eplemonsqueezys/Auto-Chicken-Coop/smart_chicken_coop.pptx

Smart Chicken Coop

An Automated Monitoring & Control System

Raspberry Pi 5 · Python · PCA9685 Servo Driver · 7 Automated Systems

## Slide 2

The Story

Why We Built This

We have a chicken coop at home with six hens. Every single day, someone had to walk out and physically check on them.
Was the water topped up? Had the door closed at dusk? Was it getting too hot inside? Had they run out of food?
If we forgot — the chickens could overheat in summer, run out of water, or be left exposed to predators overnight.
We decided to build a system that manages the coop automatically, so we can check on it from our phones instead of going outside every day.

Daily Tasks — Before Automation

Check & refill water drinker

Every morning

Open coop door at sunrise

Every morning

Close coop door at sunset

Every evening

Check temperature in summer

Hot days

Check food hopper level

Every few days

Turn run lights on/off

Daily

## Slide 3

7 Automated Systems

Temperature
Monitor

DHT22 sensor

Vent Sliders

2× MG995 servo

Circulation
Fan

12V PC fan

Water Level
Monitor

Float switches

Automatic
Door

Linear actuator

Automatic
Lights

LED strips

Food Level
Indicator

Lever + pot

## Slide 4

The Hardware

Raspberry Pi 5

Brain of the system

Runs all the Python automation code

64-bit quad-core CPU

Fast enough to handle all sensors at once

WiFi built in

Serves the debug web panel on your network

40-pin GPIO header

Connects to sensors, relays, and motor drivers

I2C + SPI buses

Talks to the PCA9685 and MCP3008 chips

Pi 5 note

Uses the new RP1 GPIO chip — needs lgpio library, not RPi.GPIO

PCA9685 — Servo Driver

Same board used in the workshop dust collection system.
Connects to Pi via I2C (just 4 wires). Controls up to 16 servos from a single board. We use channels 0 and 1 for the two vent sliders.

MCP3008 — Analog Input Chip

The Pi 5 has no analog input pins, so it can't directly read sensors that output a voltage (like the LDR or potentiometer).
The MCP3008 converts analog voltages to digital values over SPI. 8 channels — we use 2: one for the light sensor, one for the food lever.

## Slide 5

Temperature & Ventilation

How It Works

DHT22 reads every 10 sec

Measures temperature and humidity inside the coop

Above 27°C — vents open

Two MG995 servos (via PCA9685) push the vent sliders open

Below 25°C — vents close

2°C gap prevents the servos from constantly toggling

Above 30°C — fan on

12V PC fan switches on via relay to push fresh air through

Below 28°C — fan off

Fan stays off below this to avoid overcooling

Hardware

DHT22 sensor

GPIO4 — single-wire protocol

2× MG995 servo

PCA9685 CH0 + CH1

120mm 12V PC fan

12V rail via relay on GPIO17

1

2

3

if not vents_open and temp >= 27:
set_servo(CH0, SERVOMAX)
set_servo(CH1, SERVOMAX)
vents_open = True
if not fan_on and temp >= 30:
fan.on()
fan_on = True

4

5

## Slide 6

Automatic Chicken Door

How It Works

LDR reads light level

Photoresistor + 10kΩ divider feeds voltage to MCP3008 channel 0

Dawn detection

When light reads above 0.60 (bright) the door should open

Dusk detection

When light reads below 0.30 (dark) AND it's after 8pm

Clock backup

On overcast days the LDR may not trigger — door forces open by 9am

Linear actuator

L298N H-bridge drives actuator forward (open) or backward (close)

Limit switches

Two micro switches stop the motor when the door reaches each end

Hardware

LDR + 10kΩ resistor

Voltage divider → MCP3008 CH0

12V linear actuator

4-6" stroke, 50-100N, self-locking

L298N H-bridge driver

GPIO5 IN1, GPIO6 IN2

2× micro limit switch

GPIO16 (open end), GPIO20 (closed end)

1

2

3

light = ldr.value # 0.0-1.0
is_dawn = (light >= 0.60 or
hour >= 9)
is_dusk = (light <= 0.30 and
hour >= 20)
if is_dawn: open_door()
if is_dusk: close_door()

4

5

6

## Slide 7

Water Level Monitor

How It Works

3 float switches mounted vertically

One at Low, one at Mid, one at Full height inside the water container

Float rises with water level

When water reaches a switch, the float lifts and closes the circuit

Pi reads each switch

The highest active switch determines which LED lights up

Green = Full

All three switches active

Yellow = Mid

Only low and mid switches active

Red = Low / Empty

Only the lowest switch, or none — time to refill

Hardware

3× vertical float switch (NO)

GPIO22 low / GPIO23 mid / GPIO24 high

Red LED

GPIO25 — low/empty

Yellow LED

GPIO27 — mid level

Green LED

GPIO18 — full

1

2

3

if water_high.is_active:
led_green.on() # Full
elif water_mid.is_active:
led_yellow.on() # Mid
elif water_low.is_active:
led_red.on() # Low
else:
led_red.on() # Empty

4

5

6

## Slide 8

Food Level Indicator

How It Works

Lever arm sits in the food hopper

One end of the arm rests on top of the food. As food is eaten, the arm drops

Potentiometer at the pivot point

As the lever rotates, the pot wiper moves — outputting a different voltage

MCP3008 reads the voltage

Converts the analog voltage (0–3.3V) to a digital value (0.0–1.0)

1.0 = full, 0.0 = empty

After fitting the lever, FOOD_LOW_THRESHOLD in config.py is calibrated

Below 25% — red LED on

Exterior panel light turns red, visible from outside the coop

Above 25% — green LED on

Green means the hopper has enough food

Hardware

10kΩ rotary potentiometer

Mounted at lever pivot → MCP3008 CH1

Lever arm

Custom-built, sits in the feeder hopper

Red LED + 220Ω

GPIO21 — needs food

Green LED + 220Ω

GPIO14 — food OK

1

2

3

# MCP3008 reads 0.0 (empty)

# to 1.0 (full)

food_level = food_pot.value
if food_level < 0.25:
food_led_red.on()
food_led_green.off()
else:
food_led_green.on()

4

5

6

## Slide 9

Automatic Lights

How It Works

Two separate light circuits

One for the interior of the coop, one for the outdoor run area

Schedule set in config.py

Default: on at 6:00am, off at 10:00pm. Change the hours without touching the code

Pi checks time every 10 seconds

Uses Python datetime — no external RTC needed because Pi 5 syncs via WiFi NTP

Relay switches the 12V circuit

Pi GPIO drives a 5V relay that controls the 12V LED strip — safe separation of voltages

State tracking prevents flicker

The code only switches when the state actually needs to change

Hardware

12V warm white LED strip

Coop interior — 2-3m

12V warm white LED strip

Run / outdoor — 3-5m

2× 5V relay module

GPIO19 coop / GPIO26 run

1

2

3

mins = now.hour * 60 + now.minute
on_min = 6 * 60 # 6:00am
off_min = 22 * 60 # 10:00pm
should_be_on = on_min <= mins < off_min
if should_be_on and not lights_on:
coop_light.on()
run_light.on()

4

5

## Slide 10

The Code

All the settings in one place — temperature thresholds, GPIO pin numbers, servo pulse values, light schedule times. Nothing is hardcoded in the main file. To change when the lights come on, you just edit one number here.

config.py

The main automation loop. Runs forever, waking up every 10 seconds to read sensors, check time, and update outputs. Each system is its own small function. The Pi 5 runs this as a system service that starts on boot.

coop_controller.py

A Flask web server that serves a control panel on your home network. Open it on any phone or laptop to manually trigger any system, see live sensor readings, and read the log — without touching the Pi.

debug_panel.py

## Slide 11

Debug Panel — Manual Control

During build and testing, we needed a way to trigger any part of the system manually without writing temporary code. We built a web-based control panel that runs on the Pi.

Live sensor readings

Temperature, humidity, light level, food %, water level, and both door limit switch states — all auto-refreshing every 5 seconds.

One-click manual control

Buttons for every system: open/close vents, fan on/off, door open/close/stop, coop lights and run lights.

Emergency door stop

A dedicated STOP button that immediately cuts the door motor — useful when testing the actuator travel before the limit switches are fitted.

Live log viewer

The last 50 lines of coop.log shown on the page, with a Refresh button. No need to SSH into the Pi to see what the controller is doing.

## Slide 12

What We Learned

Real hardware is harder than code

Getting sensors to read reliably outdoors — temperature, humidity, light — took more calibration than the software logic.

The Pi 5 is different

The new RP1 GPIO chip broke the old RPi.GPIO library. Switching to lgpio and understanding why took real debugging.

Hysteresis matters

Without a gap between on/off thresholds, the vents and fan would toggle constantly. Small design choices have big real-world effects.

Separation of concerns

Putting all configuration in config.py and keeping the logic in coop_controller.py made the code much easier to change and test.
