eplemonsqueezys/Auto-Chicken-Coop/shopping-list.md

# Chicken Coop Automation — Shopping List

> Search these names on Amazon, Adafruit, SparkFun, or AliExpress.
> Items marked ⚠️ are easy to forget but critical.

---

## Brain & Power

| Qty | Part | Search Term |
|-----|---|---|
| 1 | Raspberry Pi 5 (2GB or 4GB) | "Raspberry Pi 5 2GB" |
| 1 | MicroSD card 32GB A2 Class 10 | "SanDisk 32GB MicroSD A2" |
| 1 | Raspberry Pi 5 official 27W USB-C power supply | "Raspberry Pi 5 power supply 27W" — Pi 5 needs 5V/5A, NOT the Pi 4 supply |
| 1 | **GPIO breakout board + 40-pin ribbon cable** | "Adafruit T-Cobbler Plus" or "40 pin GPIO breakout breadboard" |
| 1 | 12V DC power supply, 5A | "12V 5A DC power supply adapter" |
| 1 | Buck converter 12V to 5V 3A | "LM2596 buck converter DC-DC step down" |

---

## Servo Driver (same as your workshop system) ⚠️

| Qty | Part | Search Term |
|-----|---|---|
| 1 | Adafruit PCA9685 16-Channel PWM Servo Driver | "PCA9685 16 channel servo driver I2C" |

> This is the exact same board as your dust collection system. Connects to the Pi via I2C (SDA/SCL).

---

## Temperature Sensor

| Qty | Part | Search Term |
|-----|---|---|
| 1 | DHT22 temperature & humidity sensor | "DHT22 AM2302 temperature humidity sensor" |
| 1 | 10kΩ resistor | "10k ohm resistor 1/4 watt" |

---

## Vent Sliders (2 servos)

| Qty | Part | Search Term |
|-----|---|---|
| 2 | MG996R high-torque metal gear servo | "MG996R servo motor metal gear" |

---

## Circulation Fan

| Qty | Part | Search Term |
|-----|---|---|
| 1 | 120mm PC case fan 12V | "120mm PC fan 12V" |
| 1 | 5V single-channel relay module | "5V relay module Arduino" |

---

## Water Level Indicator

| Qty | Part | Search Term |
|-----|---|---|
| 3 | Vertical float switch (Normally Open) | "vertical float switch NO liquid level" |
| 1 | Red LED 5mm | included in most LED packs |
| 1 | Yellow LED 5mm | included in most LED packs |
| 1 | Green LED 5mm | included in most LED packs |
| 3 | 220Ω resistors | "220 ohm resistor pack" |

---

## Automatic Chicken Door

| Qty | Part | Search Term |
|-----|---|---|
| 1 | 12V linear actuator 4"–6" stroke 50–100N | "12V linear actuator 4 inch 100N" |
| 1 | L298N dual H-bridge motor driver module | "L298N motor driver module" |
| 2 | Micro limit switch (Normally Open) | "micro limit switch NO lever arm" |
| 1 | LDR photoresistor | "LDR photoresistor 5mm GL5528" |
| 1 | 10kΩ resistor (for LDR voltage divider) | already in a resistor pack |

---

## Automatic Lights

| Qty | Part | Search Term |
|-----|---|---|
| 1 | 12V warm white LED strip 2–3m | "12V warm white LED strip 3m" |
| 1 | 12V warm white LED strip 3–5m | "12V warm white LED strip 5m" |
| 2 | 5V single-channel relay module | "5V relay module Arduino" (buy a 4-pack) |

---

## Food Level Indicator ⚠️

| Qty | Part | Search Term |
|-----|---|---|
| 1 | 10kΩ rotary potentiometer | "10k ohm potentiometer rotary knob" |
| 1 | Red LED 5mm | in LED pack |
| 1 | Green LED 5mm | in LED pack |
| 2 | 220Ω resistors | in resistor pack |

---

## Analog Input Chip ⚠️

| Qty | Part | Search Term |
|-----|---|---|
| 1 | MCP3008 8-channel SPI ADC | "MCP3008 ADC SPI 8 channel" |

> Pi has no analog inputs. This chip reads the LDR and food potentiometer.

---

## Wiring & Enclosure

| Qty | Part | Search Term |
|-----|---|---|
| 1 | 400-point breadboard | "400 point breadboard" |
| 1 | Weatherproof project enclosure IP65 | "IP65 outdoor electrical project box" |
| — | Waterproof cable glands M12 | "M12 cable gland waterproof" |
| — | Terminal block strip | "DIN rail terminal block 12 AWG" |
| — | 22 AWG hookup wire assorted | "22 AWG solid core wire kit" |
| — | Heat shrink tubing assortment | "heat shrink tubing assortment" |
| — | Zip ties | "zip tie assortment" |
| — | Jumper wires M-M and M-F | "jumper wire kit Arduino" |

---

## Tip: Buy as Packs to Save Money

These items are cheaper in kits — search for these instead of individual pieces:

- **"Arduino starter kit"** — gets you resistors, LEDs, breadboard, jumpers, relays all at once
- **"PCA9685 servo driver"** — usually sold as a module with headers pre-soldered
- **"4-pack relay module 5V"** — you need 3 relays total (fan + 2 lights)
