eplemonsqueezys/Auto-Chicken-Coop/(commit log)

2026-06-18 Added servosystem/debugmenu
2026-06-21 Switched hardware v1.2
2026-06-21 added arduino
2026-06-26 Update 1.5
    Setup system for full range sweeping instead of a set range for testing also removed the limit switch system and other tweaks
2026-06-26 1.8
    Switch to F and AM/ PM
2026-06-28 Added fan relay support
    Support for the fan relay added to arduino code
2026-06-28 1.9
    Updated Arduino code to support the fan on pin 7
